fosted3/quadcopter/hardware/V7B TI.brd

## EAGLE design hardware/V7B TI.brd (2014-03-28)

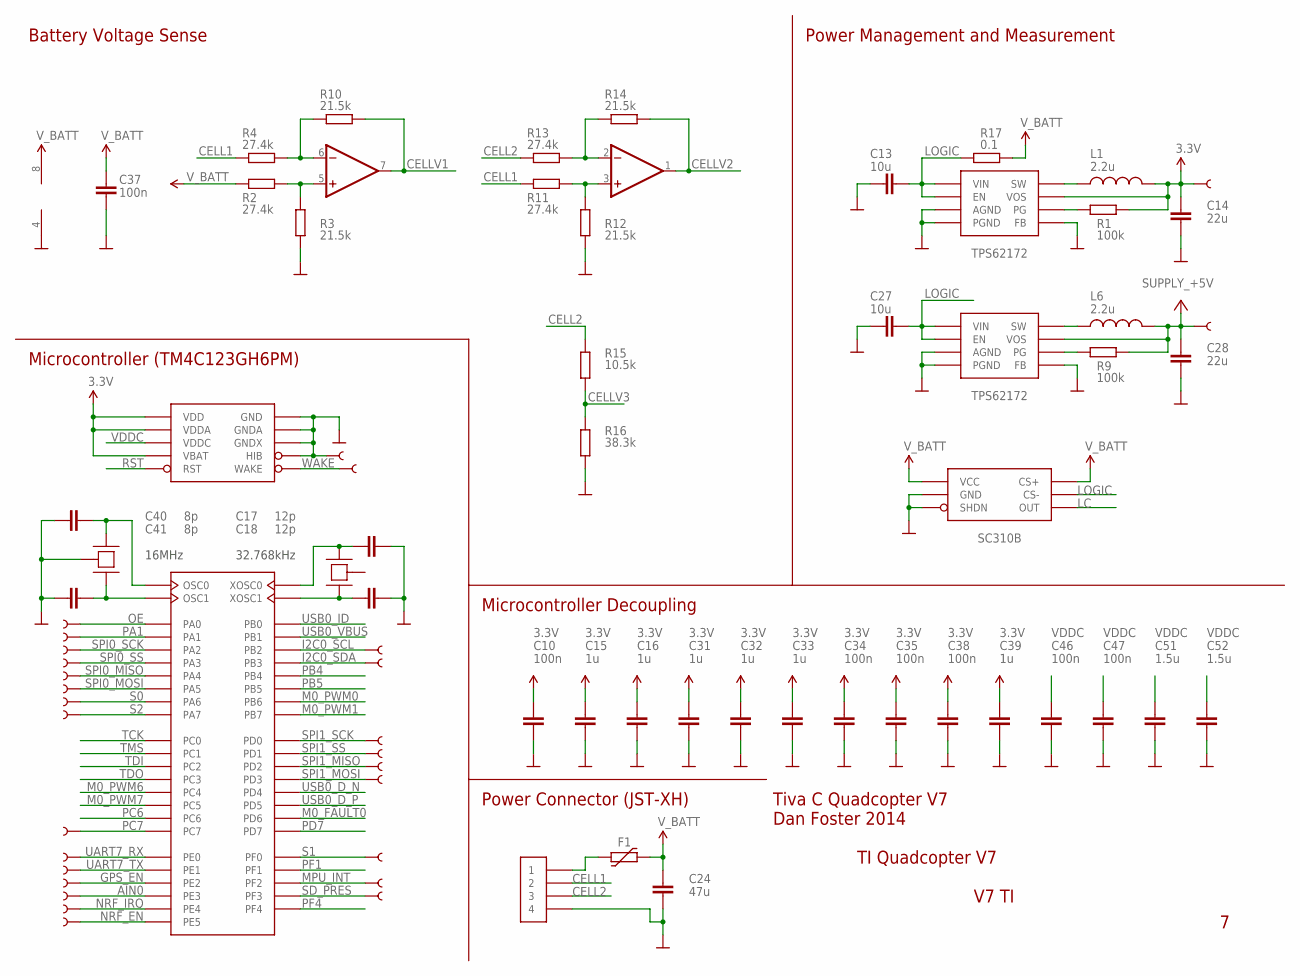
[picture p1: schematic V7B TI.sch, sheet 1]

Parts:
C10, C34, C35, C37, C38, C46, C47: 100n; C402
C13, C27: 10u; C805
C14, C28: 22u; C805
C15, C16, C31, C32, C33, C39: 1u; C402
C17, C18: 12p; C402
C24: 47u; C1206
C40, C41: 8p; C402
C51, C52: 1.5u; C402
F1: FUSE_PTC-1812; PTC1812L
IC2: OPA2743EA; MSOP08
L1, L6: 2.2u; 1210
R1, R9: 100k; R402
R2, R4, R11, R13: 27.4k; R402
R3, R10, R12, R14: 21.5k; R402
R15: 10.5k; R402
R16: 38.3k; R402
R17: 0.1; R1206
TP1, TP2, TP3, TP4, TP5, TP6, TP7, TP8, TP9, TP10, TP11, TP12, TP13, TP14, TP15, TP16, TP17, TP18, TP19, TP20, TP21, TP22, TP23, TP24, TP25, TP26, TP27, TP29: TEST-POINT3; PAD.03X.03
U$2, U$4: TPS62172; S-PWSON-N8
U$5: TM4C123GH6PM; TI-PM
U$6: JST-XH-4-SMD
U$7: CRYSTAL-3.2X2.5; TSX-3225
U$9: SC130; SOT-23-6
U$12: CRYSTAL-WATCH-SMD

Connections:
3.3V: C10.1, C14.2, C15.1, C16.1, C31.1, C32.1, C33.1, C34.1, C35.1, C38.1, C39.1, L1.2, R1.1, TP15.P$1, U$2.6 (VOS), U$5.P$2 (VDDA), U$5.P$11 (VDD), U$5.P$26 (VDD), U$5.P$37 (VBAT), U$5.P$42 (VDD), U$5.P$54 (VDD); also elsewhere on the board
+5V: C28.2, L6.2, R9.1, TP14.P$1, U$4.6 (VOS); also elsewhere on the board
AIN0: TP11.P$1, U$5.P$6 (PE3); also elsewhere on the board
CASE: U$12.BODY (CASE)
CELL1: R4.1, R11.1, U$6.2
CELL2: R13.1, R15.2, U$6.3
CELLV1: IC2.7 (OUT), R10.2; also elsewhere on the board
CELLV2: IC2.1 (OUT), R14.2; also elsewhere on the board
CELLV3: R15.1, R16.2; also elsewhere on the board
GND: C10.2, C13.2, C14.1, C15.2, C16.2, C17.2, C18.2, C24.2, C27.2, C28.1, C31.2, C32.2, C33.2, C34.2, C35.2, C37.2, C38.2, C39.2, C40.1, C41.1, C46.2, C47.2, C51.2, C52.2, IC2.4 (V-), R3.1, R12.1, R16.1, TP16.P$1, U$2.1 (PGND), U$2.4 (AGND), U$2.5 (FB), U$2.PAD (AGND), U$2.VIA1 (AGND), U$2.VIA2 (AGND), U$4.1 (PGND), U$4.4 (AGND), U$4.5 (FB), U$4.PAD (AGND), U$4.VIA1 (AGND), U$4.VIA2 (AGND), U$5.P$3 (GNDA), U$5.P$12 (GND), U$5.P$27 (GND), U$5.P$33 (HIB), U$5.P$35 (GNDX), U$5.P$39 (GND), U$5.P$55 (GND), U$6.4, U$7.G1 (CASE), U$7.G2 (CASE), U$9.1 (SHDN), U$9.2 (GND); also elsewhere on the board
GPS_EN: TP21.P$1, U$5.P$7 (PE2); also elsewhere on the board
I2C0_SCL: TP5.P$1, U$5.P$47 (PB2); also elsewhere on the board
I2C0_SDA: TP6.P$1, U$5.P$48 (PB3); also elsewhere on the board
LC: U$9.6 (OUT); also elsewhere on the board
LOGIC: C13.1, C27.1, R17.1, U$2.2 (VIN), U$2.3 (EN), U$4.2 (VIN), U$4.3 (EN), U$9.5 (CS-)
M0_FAULT0: U$5.P$53 (PD6)
M0_PWM0: U$5.P$1 (PB6); also elsewhere on the board
M0_PWM1: U$5.P$4 (PB7); also elsewhere on the board
M0_PWM6: U$5.P$16 (PC4); also elsewhere on the board
M0_PWM7: U$5.P$15 (PC5); also elsewhere on the board
MPU_INT: TP29.P$1, U$5.P$30 (PF2); also elsewhere on the board
unnamed: IC2.5 (+IN), R2.2, R3.2
unnamed: L1.1, U$2.7 (SW)
unnamed: C17.1, U$5.P$34 (XOSC0), U$12.2 (C2)
unnamed: R1.2, U$2.8 (PG)
unnamed: IC2.6 (-IN), R4.2, R10.1
unnamed: C18.1, U$5.P$36 (XOSC1), U$12.1 (C1)
unnamed: L6.1, U$4.7 (SW)
unnamed: R9.2, U$4.8 (PG)
unnamed: F1.1, U$6.1
unnamed: IC2.3 (+IN), R11.2, R12.2
unnamed: IC2.2 (-IN), R13.2, R14.1
unnamed: C40.2, U$5.P$40 (OSC0), U$7.C1
unnamed: C41.2, U$5.P$41 (OSC1), U$7.C2
NRF_EN: TP19.P$1, U$5.P$60 (PE5); also elsewhere on the board
NRF_IRQ: TP18.P$1, U$5.P$59 (PE4); also elsewhere on the board
OE: TP24.P$1, U$5.P$17 (PA0); also elsewhere on the board
PA1: TP25.P$1, U$5.P$18 (PA1)
PB4: U$5.P$58 (PB4)
PB5: U$5.P$57 (PB5)
PC6: U$5.P$14 (PC6)
PC7: TP27.P$1, U$5.P$13 (PC7)
PD7: U$5.P$10 (PD7)
PF1: U$5.P$29 (PF1)
PF4: U$5.P$5 (PF4)
RST: U$5.P$38 (RST); also elsewhere on the board
S0: TP12.P$1, U$5.P$23 (PA6); also elsewhere on the board
S1: TP10.P$1, U$5.P$28 (PF0); also elsewhere on the board
S2: TP13.P$1, U$5.P$24 (PA7); also elsewhere on the board
SD_PRES: TP20.P$1, U$5.P$31 (PF3); also elsewhere on the board
SPI0_MISO: TP3.P$1, U$5.P$21 (PA4); also elsewhere on the board
SPI0_MOSI: TP4.P$1, U$5.P$22 (PA5); also elsewhere on the board
SPI0_SCK: TP1.P$1, U$5.P$19 (PA2); also elsewhere on the board
SPI0_SS: TP2.P$1, U$5.P$20 (PA3); also elsewhere on the board
SPI1_MISO: TP9.P$1, U$5.P$63 (PD2); also elsewhere on the board
SPI1_MOSI: TP17.P$1, U$5.P$64 (PD3); also elsewhere on the board
SPI1_SCK: TP7.P$1, U$5.P$61 (PD0); also elsewhere on the board
SPI1_SS: TP8.P$1, U$5.P$62 (PD1); also elsewhere on the board
TCK: U$5.P$52 (PC0); also elsewhere on the board
TDI: U$5.P$50 (PC2); also elsewhere on the board
TDO: U$5.P$49 (PC3); also elsewhere on the board
TMS: U$5.P$51 (PC1); also elsewhere on the board
UART7_RX: TP23.P$1, U$5.P$9 (PE0); also elsewhere on the board
UART7_TX: TP22.P$1, U$5.P$8 (PE1); also elsewhere on the board
USB0_D_N: U$5.P$43 (PD4)
USB0_D_P: U$5.P$44 (PD5)
USB0_ID: U$5.P$45 (PB0)
USB0_VBUS: U$5.P$46 (PB1)
VDDC: C46.1, C47.1, C51.1, C52.1, U$5.P$25 (VDDC), U$5.P$56 (VDDC)
V_BATT: C24.1, C37.1, F1.2, IC2.8 (V+), R2.1, R17.2, U$9.3 (VCC), U$9.4 (CS+)
WAKE: TP26.P$1, U$5.P$32 (WAKE); also elsewhere on the board

Notes on the sheet:
Microcontroller (TM4C123GH6PM)
16MHz
32.768kHz
Power Connector (JST-XH)
TI Quadcopter V7
V7 TI
Tiva C Quadcopter V7 Dan Foster 2014
Microcontroller Decoupling
Battery Voltage Sense
Power Management and Measurement
TPS62172
SC310B

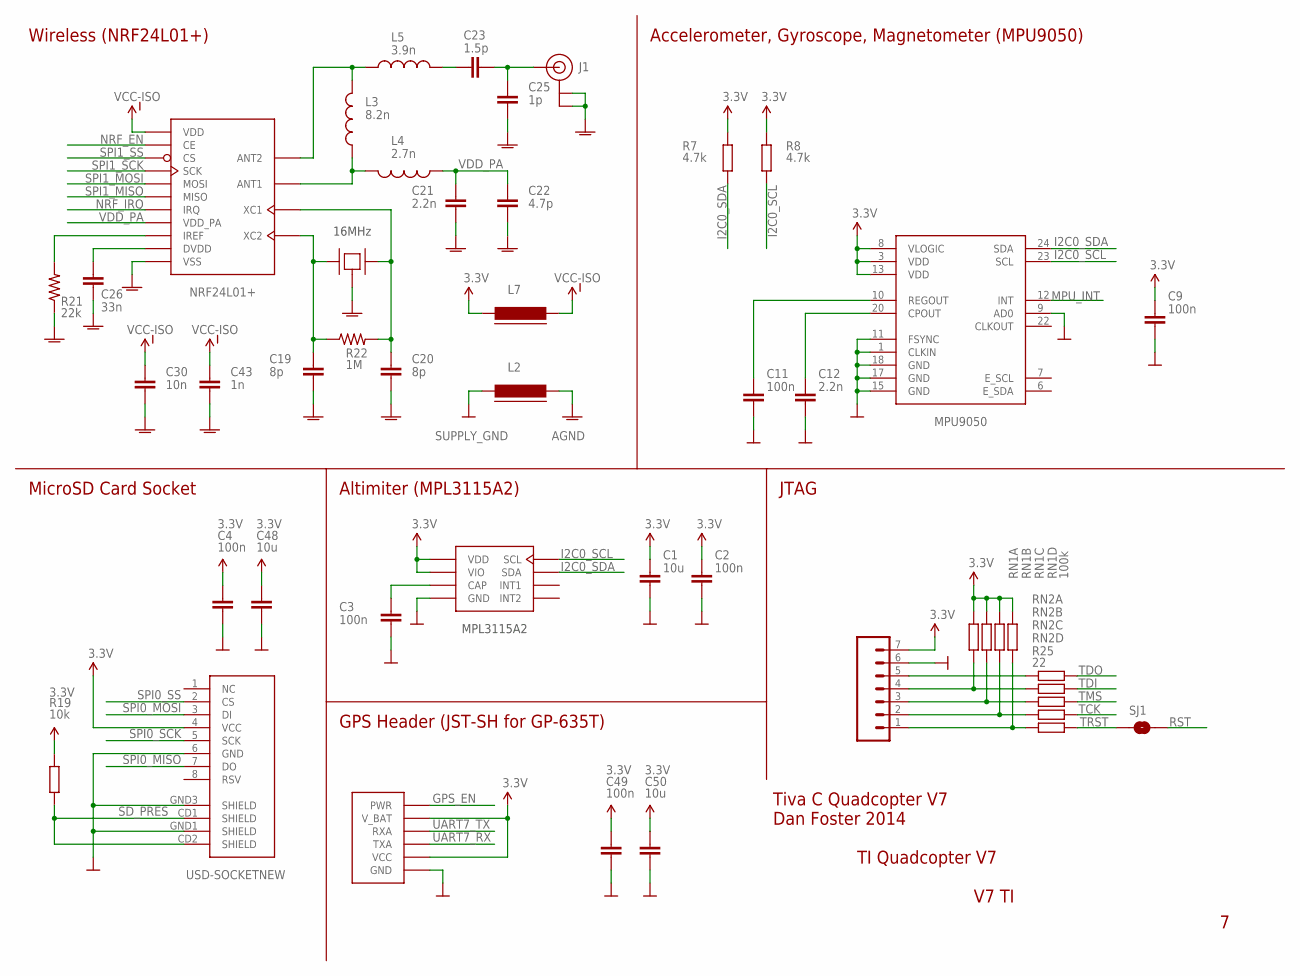
[picture p2: schematic V7B TI.sch, sheet 2]

Parts:
C1, C48, C50: 10u; C603
C2, C3, C4, C9, C11, C49: 100n; C402
C12: 2.2n; C402
C19, C20: 8p; 0402-CAP
C21: 2.2n; 0402-CAP
C22: 4.7p; 0402-CAP
C23: 1.5p; 0402-CAP
C25: 1p; 0402-CAP
C26: 33n; 0402-CAP
C30: 10n; 0402-CAP
C43: 1n; 0402-CAP
J1: U.FL
JP5: M07; 1X07
L2, L7: 445-8677-1-ND; FB603
L3: 8.2n; C0402
L4: 2.7n; C0402
L5: 3.9n; C0402
R7, R8: 4.7k; R402
R19: 10k; R402
R21: 22k; 0402-RES
R22: 1M; 0402-RES
R25: 22; R402
RN1: 100k; RN8P-4R-CRA06S
RN2: 22; RN8P-4R-CRA06S
SJ1: SOLDERJUMPERNO; SJ_2S-NO
U1: MPU9050; QFN-24-NP
U2: USD-SOCKETNEW; MICRO-SD-SOCKET-PP
U$3: MPL3115A2; MPLXXXXAX
U$10: GPS-GP-635T-VERT; JST-SH-6-SMD-T
U$11: NRF24L01+; QFN-20-4X4-0.5
U$13: CRYSTAL-3.2X2.5; TSX-3225

Connections:
3.3V: C1.1, C2.1, C4.1, C9.1, C48.1, C49.1, C50.1, JP5.7, L7.1, R7.1, R8.1, R19.2, RN1.5 (2), RN1.6 (2), RN1.7 (2), RN1.8 (2), U1.3 (VDD), U1.8 (VLOGIC), U1.13 (VDD), U2.4 (VCC), U$3.1 (VDD), U$3.4 (VIO), U$10.2 (VCC), U$10.5 (V_BAT); also elsewhere on the board
AGND: C19.2, C20.2, C21.2, C22.2, C25.2, C26.2, C30.2, C43.2, J1.P$1 (GND), J1.P$2 (GND), L2.2, R21.1, U$11.P$8 (VSS), U$11.P$14 (VSS), U$11.P$17 (VSS), U$11.P$20 (VSS), U$13.G1 (CASE), U$13.G2 (CASE)
GND: C1.2, C2.2, C3.2, C4.2, C9.2, C11.2, C12.2, C48.2, C49.2, C50.2, JP5.6, L2.1, U1.1 (CLKIN), U1.9 (AD0), U1.11 (FSYNC), U1.15 (GND), U1.17 (GND), U1.18 (GND), U2.6 (GND), U2.GND1 (SHIELD), U2.GND3 (SHIELD), U$3.3 (GND), U$10.1 (GND); also elsewhere on the board
GPS_EN: U$10.6 (PWR); also elsewhere on the board
I2C0_SCL: R8.2, U1.23 (SCL), U$3.8 (SCL); also elsewhere on the board
I2C0_SDA: R7.2, U1.24 (SDA), U$3.7 (SDA); also elsewhere on the board
MPU_INT: U1.12 (INT); also elsewhere on the board
unnamed: C12.1, U1.20 (CPOUT)
unnamed: C11.1, U1.10 (REGOUT)
unnamed: C19.1, R22.1, U$11.P$9 (XC2), U$13.C1
unnamed: C20.1, R22.2, U$11.P$10 (XC1), U$13.C2
unnamed: C3.1, U$3.2 (CAP)
unnamed: C23.2, C25.1, J1.P$3 (SIGNAL)
unnamed: C26.1, U$11.P$19 (DVDD)
unnamed: L3.1, L4.2, U$11.P$12 (ANT1)
unnamed: L3.2, L5.1, U$11.P$13 (ANT2)
unnamed: C23.1, L5.2
unnamed: R21.2, U$11.P$16 (IREF)
unnamed: JP5.5, RN2.1
unnamed: JP5.4, RN1.1, RN2.2 (1)
unnamed: JP5.3, RN1.2 (1), RN2.3 (1)
unnamed: JP5.2, RN1.3 (1), RN2.4 (1)
unnamed: JP5.1, R25.1, RN1.4 (1)
NRF_EN: U$11.P$1 (CE); also elsewhere on the board
NRF_IRQ: U$11.P$6 (IRQ); also elsewhere on the board
RST: SJ1.2; also elsewhere on the board
SD_PRES: R19.1, U2.CD1 (SHIELD), U2.CD2 (SHIELD); also elsewhere on the board
SPI0_MISO: U2.7 (DO); also elsewhere on the board
SPI0_MOSI: U2.3 (DI); also elsewhere on the board
SPI0_SCK: U2.5 (SCK); also elsewhere on the board
SPI0_SS: U2.2 (CS); also elsewhere on the board
SPI1_MISO: U$11.P$5 (MISO); also elsewhere on the board
SPI1_MOSI: U$11.P$4 (MOSI); also elsewhere on the board
SPI1_SCK: U$11.P$3 (SCK); also elsewhere on the board
SPI1_SS: U$11.P$2 (CS); also elsewhere on the board
TCK: RN2.5 (2); also elsewhere on the board
TDI: RN2.7 (2); also elsewhere on the board
TDO: RN2.8 (2); also elsewhere on the board
TMS: RN2.6 (2); also elsewhere on the board
TRST: R25.2, SJ1.1
UART7_RX: U$10.3 (TXA); also elsewhere on the board
UART7_TX: U$10.4 (RXA); also elsewhere on the board
VCC-ISO: C30.1, C43.1, L7.2, U$11.P$7 (VDD), U$11.P$15 (VDD), U$11.P$18 (VDD)
VDD_PA: C21.1, C22.1, L4.1, U$11.P$11 (VDD_PA)

Notes on the sheet:
16MHz
MPL3115A2
MicroSD Card Socket
Altimiter (MPL3115A2)
Wireless (NRF24L01+)
Accelerometer, Gyroscope, Magnetometer (MPU9050)
GPS Header (JST-SH for GP-635T)
JTAG
TI Quadcopter V7
V7 TI
Tiva C Quadcopter V7 Dan Foster 2014

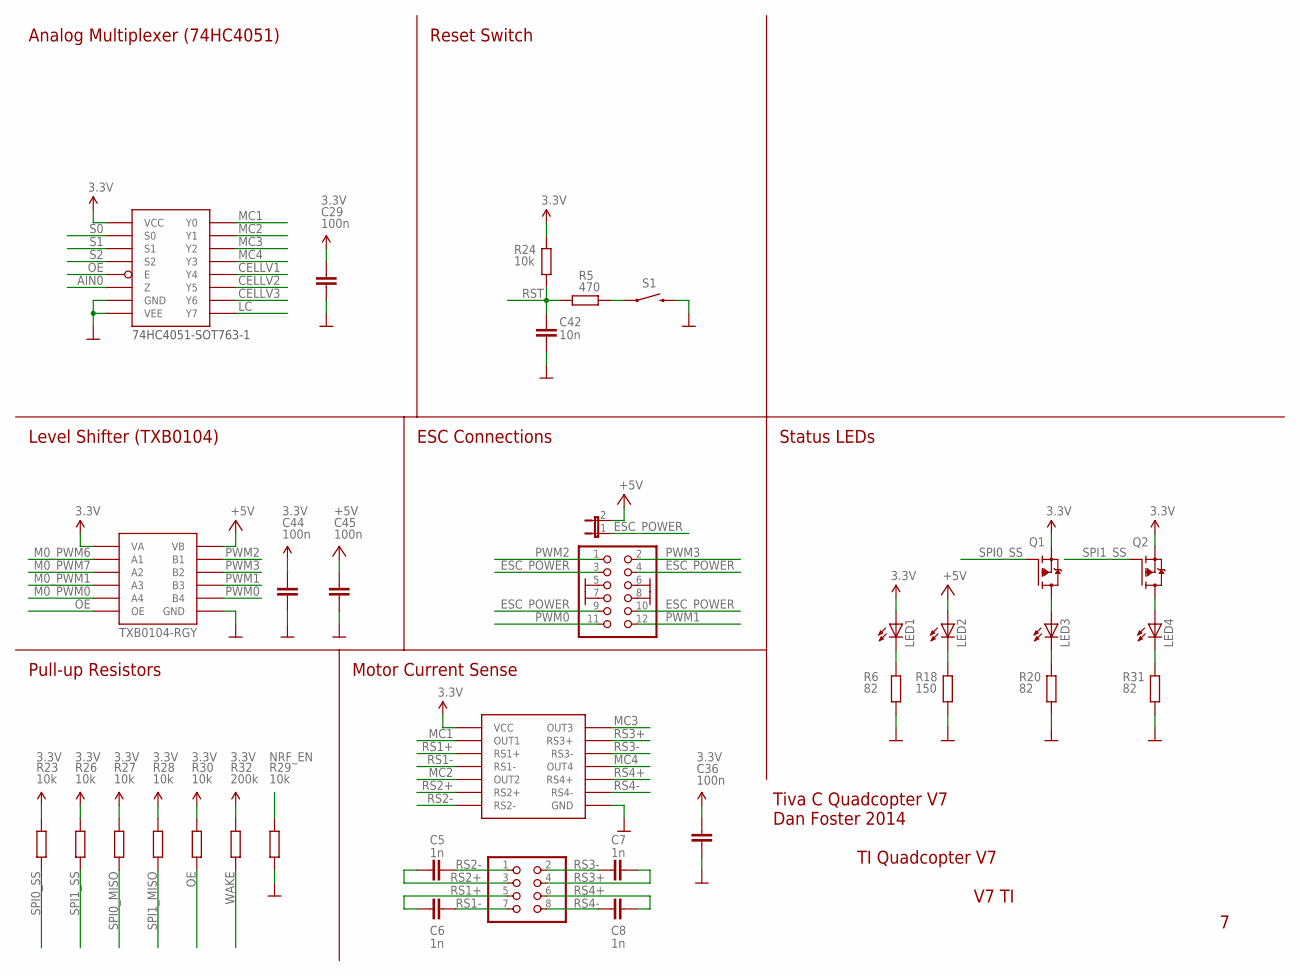
[picture p3: schematic V7B TI.sch, sheet 3]

Parts:
C5, C6, C7, C8: 1n; C402
C29, C36, C44, C45: 100n; C402
C42: 10n; C402
JP1: PINHD-2X6; 2X06
JP2: PINHD-2X4; 2X04
JP3: JUMPER-2SMD-NO; SJ_2S-NO
LED1, LED2, LED3, LED4: LED-0603; LED-603
Q1, Q2: BSS84CT-ND; SOT-23
R5: 470; R402
R6, R20, R31: 82; R603
R18: 150; R603
R23, R24, R26, R27, R28, R29, R30: 10k; R402
R32: 200k; R402
S1: SWITCH-MOMENTARY-2SMD; TACTILE_SWITCH_SMD
U$1: MAX4378XAUD+; TSSOP-14
U$8: 74HC4051; NXP-SOT763-1
U$18: TXB0104-RGY; TI-RGY

Connections:
3.3V: C29.1, C36.1, C44.1, LED1.A, Q1.2 (S), Q2.2 (S), R23.2, R24.2, R26.2, R27.2, R28.2, R30.2, R32.1, U$1.P$4 (VCC), U$8.16 (VCC), U$8.PAD (VCC), U$18.1 (VA); also elsewhere on the board
+5V: C45.1, JP3.2, LED2.A, U$18.14 (VB); also elsewhere on the board
AIN0: U$8.3 (Z); also elsewhere on the board
CELLV1: U$8.1 (Y4); also elsewhere on the board
CELLV2: U$8.5 (Y5); also elsewhere on the board
CELLV3: U$8.2 (Y6); also elsewhere on the board
ESC_POWER: JP1.3, JP1.4, JP1.9, JP1.10, JP3.1
GND: C29.2, C36.2, C42.2, C44.2, C45.2, JP1.5, JP1.6, JP1.7, JP1.8, R6.2, R18.2, R20.2, R29.1, R31.2, S1.3 (2), U$1.P$11 (GND), U$8.7 (VEE), U$8.8 (GND), U$18.7 (GND), U$18.PAD (GND), U$18.V1 (GND), U$18.V2 (GND), U$18.V3 (GND), U$18.V4 (GND); also elsewhere on the board
LC: U$8.4 (Y7); also elsewhere on the board
M0_PWM0: U$18.5 (A4); also elsewhere on the board
M0_PWM1: U$18.4 (A3); also elsewhere on the board
M0_PWM6: U$18.2 (A1); also elsewhere on the board
M0_PWM7: U$18.3 (A2); also elsewhere on the board
MC1: U$1.P$1 (OUT1), U$8.13 (Y0)
MC2: U$1.P$7 (OUT2), U$8.14 (Y1)
MC3: U$1.P$8 (OUT3), U$8.15 (Y2)
MC4: U$1.P$14 (OUT4), U$8.12 (Y3)
unnamed: LED1.C, R6.1
unnamed: R5.2, S1.1
unnamed: LED2.C, R18.1
unnamed: LED3.A, Q1.3 (D)
unnamed: LED3.C, R20.1
unnamed: LED4.C, R31.1
unnamed: LED4.A, Q2.3 (D)
NRF_EN: R29.2; also elsewhere on the board
OE: R30.1, U$8.6 (E), U$18.8 (OE); also elsewhere on the board
PWM0: JP1.11, U$18.10 (B4)
PWM1: JP1.12, U$18.11 (B3)
PWM2: JP1.1, U$18.13 (B1)
PWM3: JP1.2, U$18.12 (B2)
RS1+: C6.1, JP2.5, U$1.P$3 (RS1+)
RS1-: C6.2, JP2.7, U$1.P$2 (RS1-)
RS2+: C5.1, JP2.3, U$1.P$5 (RS2+)
RS2-: C5.2, JP2.1, U$1.P$6 (RS2-)
RS3+: C7.2, JP2.4, U$1.P$10 (RS3+)
RS3-: C7.1, JP2.2, U$1.P$9 (RS3-)
RS4+: C8.2, JP2.6, U$1.P$12 (RS4+)
RS4-: C8.1, JP2.8, U$1.P$13 (RS4-)
RST: C42.1, R5.1, R24.1; also elsewhere on the board
S0: U$8.11 (S0); also elsewhere on the board
S1: U$8.10 (S1); also elsewhere on the board
S2: U$8.9 (S2); also elsewhere on the board
SPI0_MISO: R27.1; also elsewhere on the board
SPI0_SS: Q1.1 (G), R23.1; also elsewhere on the board
SPI1_MISO: R28.1; also elsewhere on the board
SPI1_SS: Q2.1 (G), R26.1; also elsewhere on the board
WAKE: R32.2; also elsewhere on the board

Notes on the sheet:
Pull-up Resistors
Motor Current Sense
Level Shifter (TXB0104)
ESC Connections
Status LEDs
Reset Switch
Analog Multiplexer (74HC4051)
74HC4051-SOT763-1
TI Quadcopter V7
Tiva C Quadcopter V7 Dan Foster 2014
V7 TI

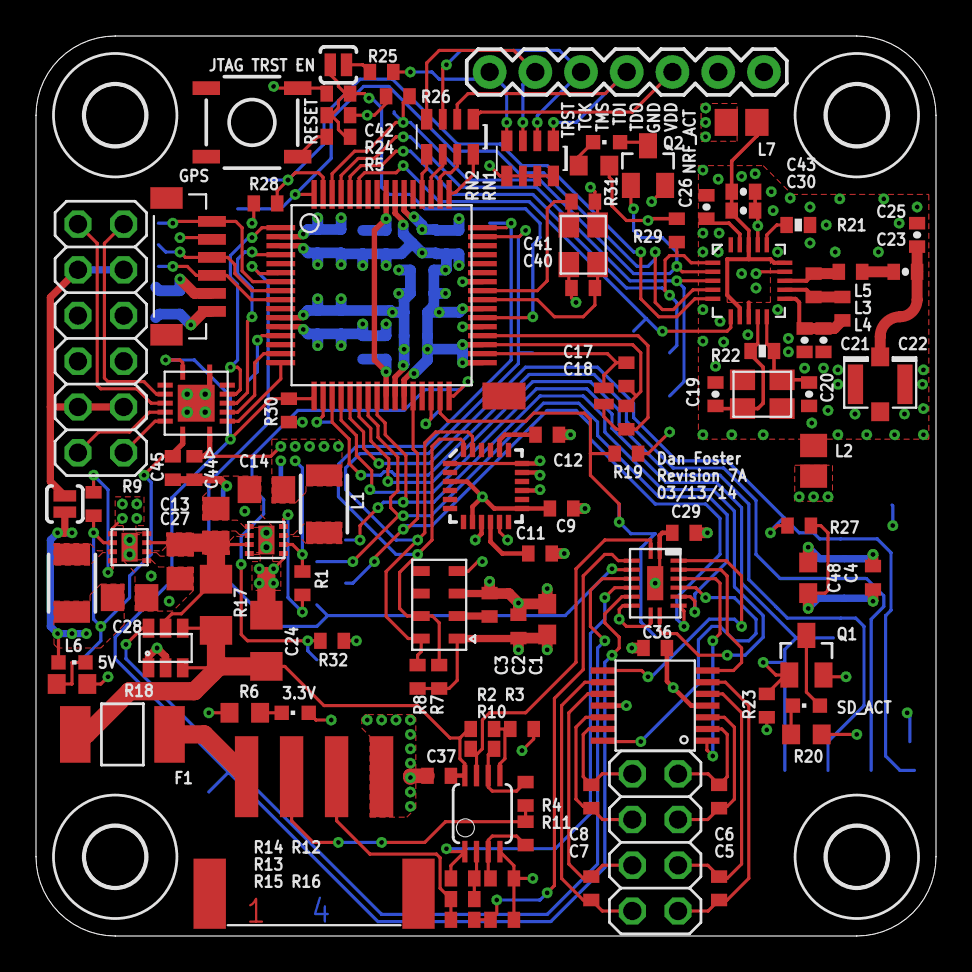
[picture p4: board V7B TI.brd from above]

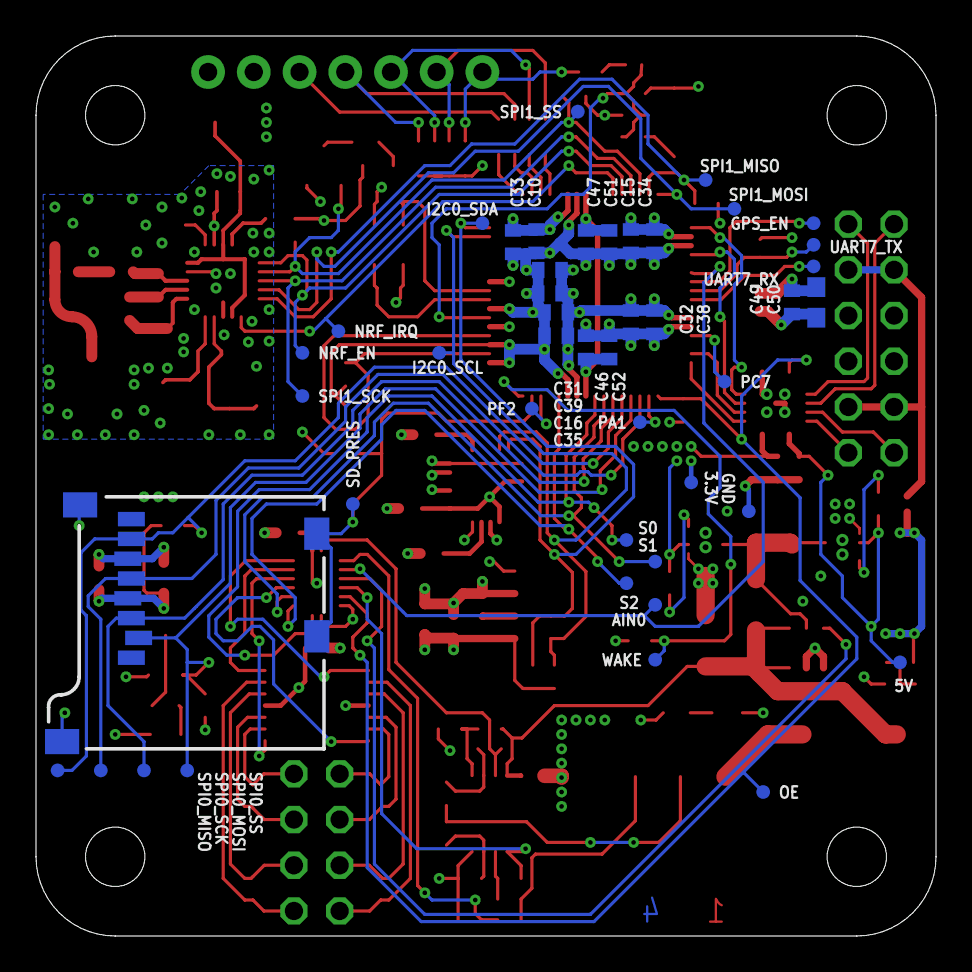
[picture p5: board V7B TI.brd from below]

Board: 4 copper layers, 50.0 x 50.0 mm, 156 parts (45 on the bottom side), 103 nets.

Other parts of the board:
U$19, U$20, U$21, U$22: 3,3
