fosted3/quadcopter/(commit log)

2014-03-25 debugging interface things
    [busblaster.cfg]
2014-03-26 changed driverlib calls to ROM_
2014-03-27 Started MPU9150 driver
2014-03-28 Added some hardware files
    [V7B TI.brd, V7B TI.sch]
